sudo-apt-install-tap/Sonder/BOM.csv

Item | Qty | Supplier | Cost/item | Total Cost | link
PCB | 1 | JLCPCB | $1.50 | $1.50 | https://jlcpcb.com/
PCM5102 I2S Digital Audio DAC Decoder Module | 1 | hubtronics | $5.00 | $5.00 | https://hubtronics.in/pcm5102-i2s-digital-audio-dac-decoder-module
Robocraze ESP32 38 Pin | 1 | AMAZON | $6.50 | $6.50 | https://www.amazon.in/Robocraze-Development-Dual-Core-Performance-Bluetooth/dp/B078MNG9D5
SD Card Reader Module | 1 | ROBU | $1.00 | $1.00 | https://robu.in/product/micro-sd-card-module/
0.96 Inch I2C/IIC 4pin | 1 | ROBU | $2.00 | $2.00 | https://robu.in/product/4pin-oled-display-module-blue-color/
Rotary Encoder with Switch | 1 | ROBU | $1.00 | $1.00 | https://robu.in/product/hongyan-ec11h-7ce20p1zd20-rotary-encoder-with-push-button-switch-vertical-plug-in-5-pin/
Tactile push buttons 6x6x8 | 1 | ROBU | $0.50 | $0.50 | https://robu.in/product/6x6x8mm-tactile-push-button-switch-pack-of-20/
HIKVISION Extreme 16GB microSDXC Memory Card | 1 | Amazon | $6.50 | $6.50 | https://www.amazon.in/HIKVISION-microSDXC-Compitable-Smartphones-Protection/dp/B0GVJZ56K5
CASE 3d print | 1 | Print Legion | $3.00 | $3.00 | https://hackclub.slack.com/archives/C083P4FJM46/p1793539514844309
Estimated total shipping | 1 |  |  | $3.00
