sudo-apt-install-tap/Sonder/CAD/pcb-Edge_Cuts.dxf

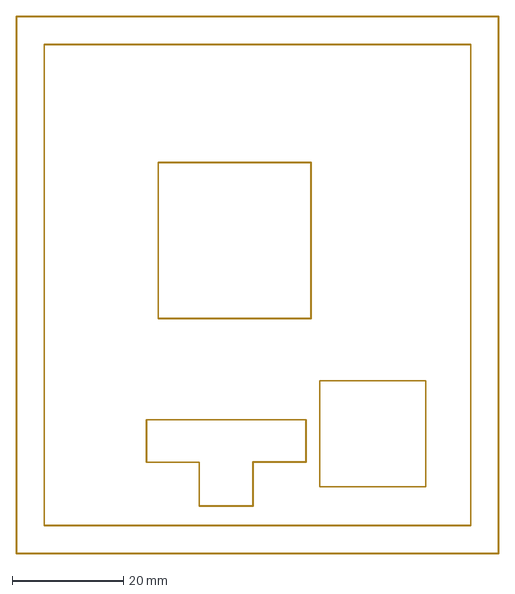
[picture p1: CAD file, 2026-11-01]
CAD/pcb-Edge_Cuts.dxf
86.6 x 96.5 mm
