sudo-apt-install-tap/Sonder/CAD/Case.step

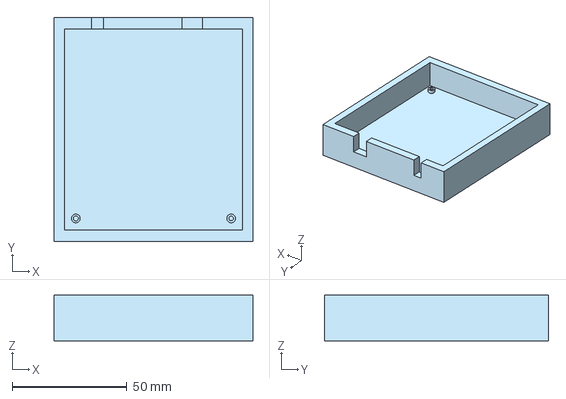
[picture p2: CAD file, 2026-11-01]
CAD/Case.step
86.6 x 97.4 x 20.0 mm
