sudo-apt-install-tap/Sonder/CAD/Plate.step

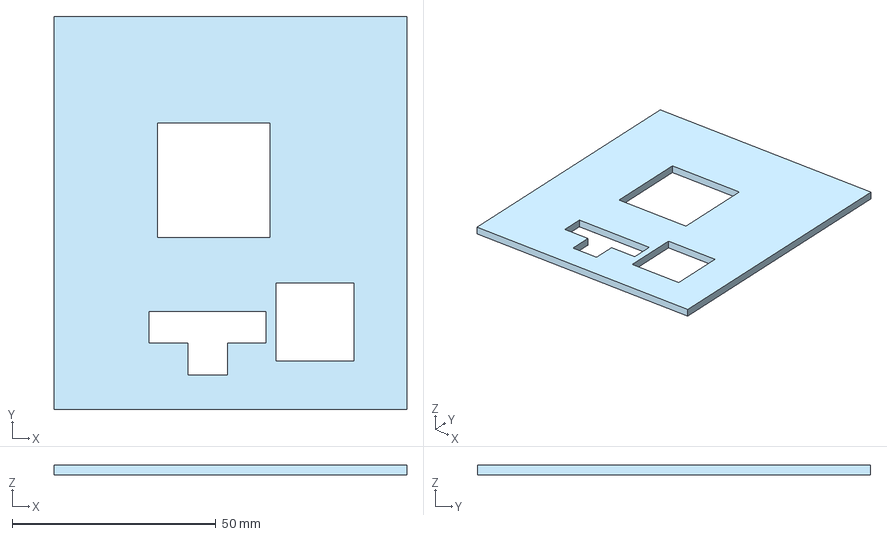
[picture p3: CAD file, 2026-11-01]
CAD/Plate.step
86.5 x 96.4 x 2.50 mm
