sudo-apt-install-tap/Sonder/CAD/pcb.step

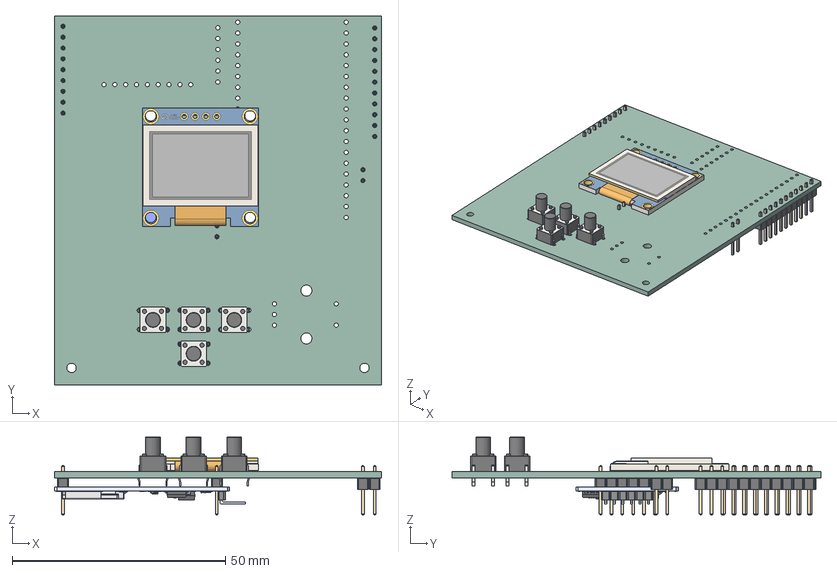
[picture p4: CAD file, 2026-11-01]
CAD/pcb.step
76.6 x 86.4 x 18.2 mm
SW_PUSH_6mm_h8mm x 4
OLED-TH_L27.8-W27.2-P2.54_C9900033791
PinHeader_1x06_P254mm_Vertical
Valor predeterminado
PinHeader_1x11_P254mm_Vertical
PinHeader_1x09_P254mm_Vertical
PinHeader_1x02_P254mm_Vertical
pcb-unsaved-export-SAPEkO_PCB
