sudo-apt-install-tap/Sonder/pcb/pcb.pdf

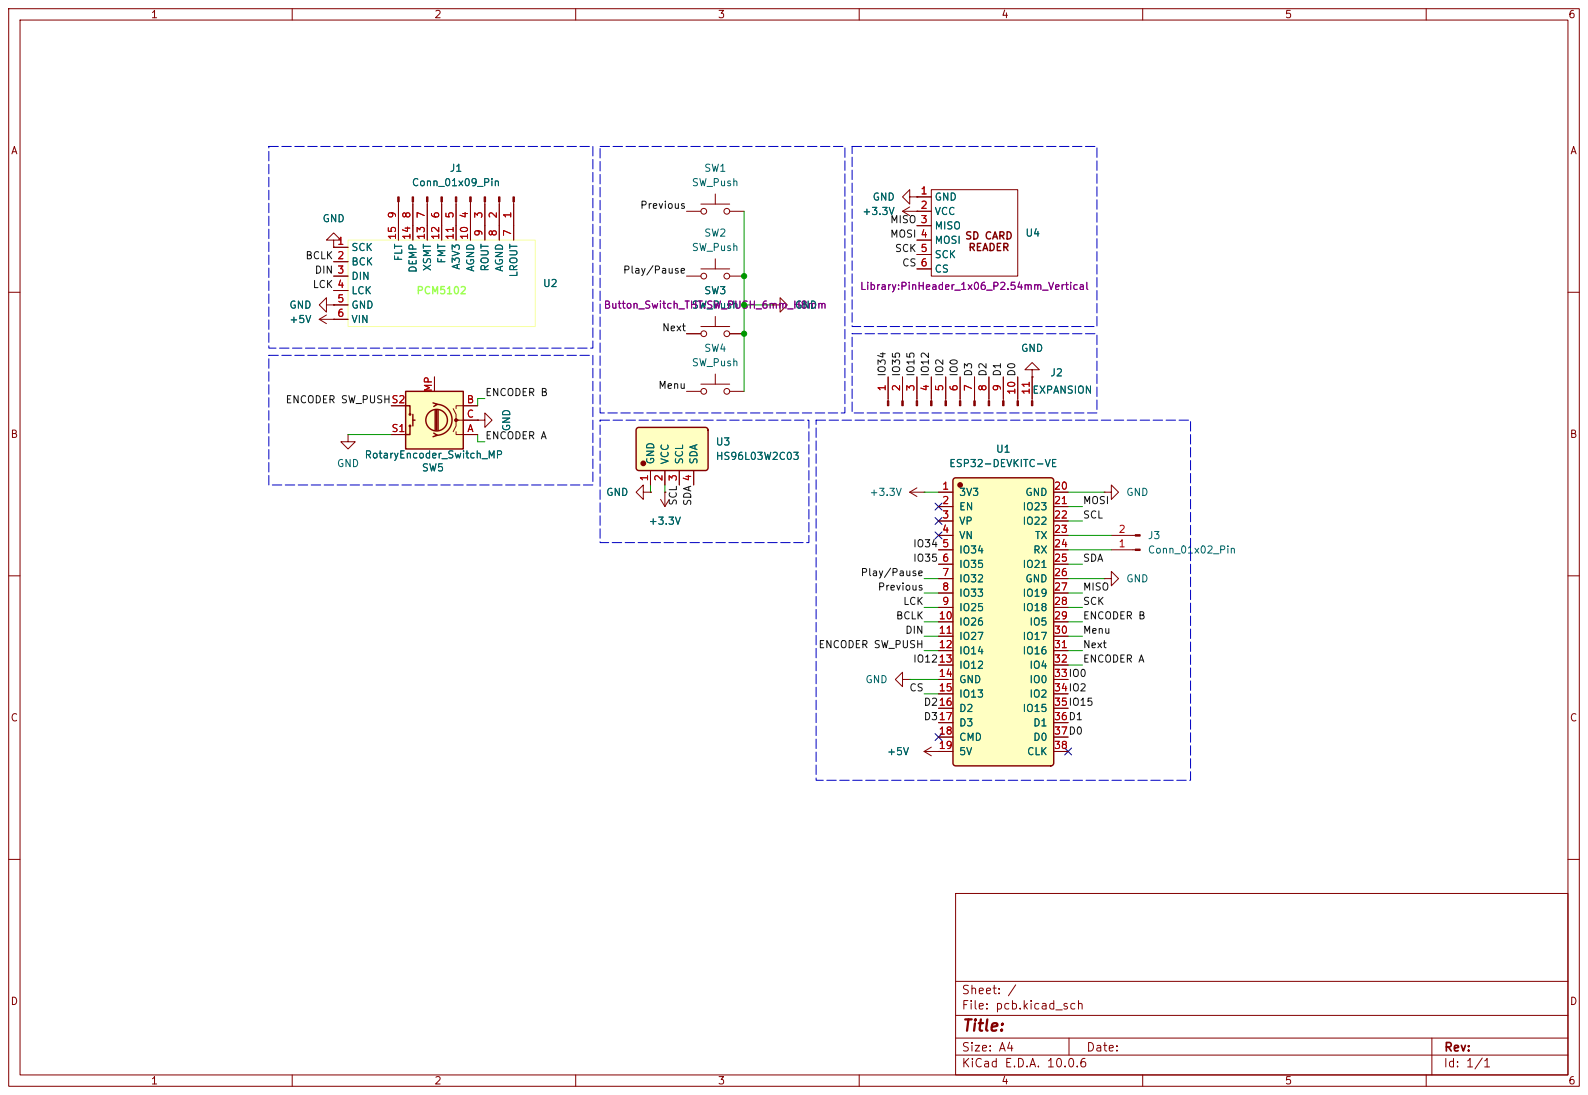
[picture p5: page 1]

8 ROUT 9 AGND 10 A3V3 11 FMT 12 XSMT 13 DEMP 14 FLT 15 U2 GND

8 ROUT 9 AGND 10 A3V3 11 FMT 12 XSMT 13 DEMP 14 FLT 15 GND U1

Play/Pause Next Menu ENCODER B

Size: A4 | Rev:
KiCad E.D.A. 10.0.6 | Id: 1/1
