sudo-apt-install-tap/Sonder/pcb/pcb.kicad_pcb

## KiCad design pcb/pcb.kicad_pcb (2026-11-01)

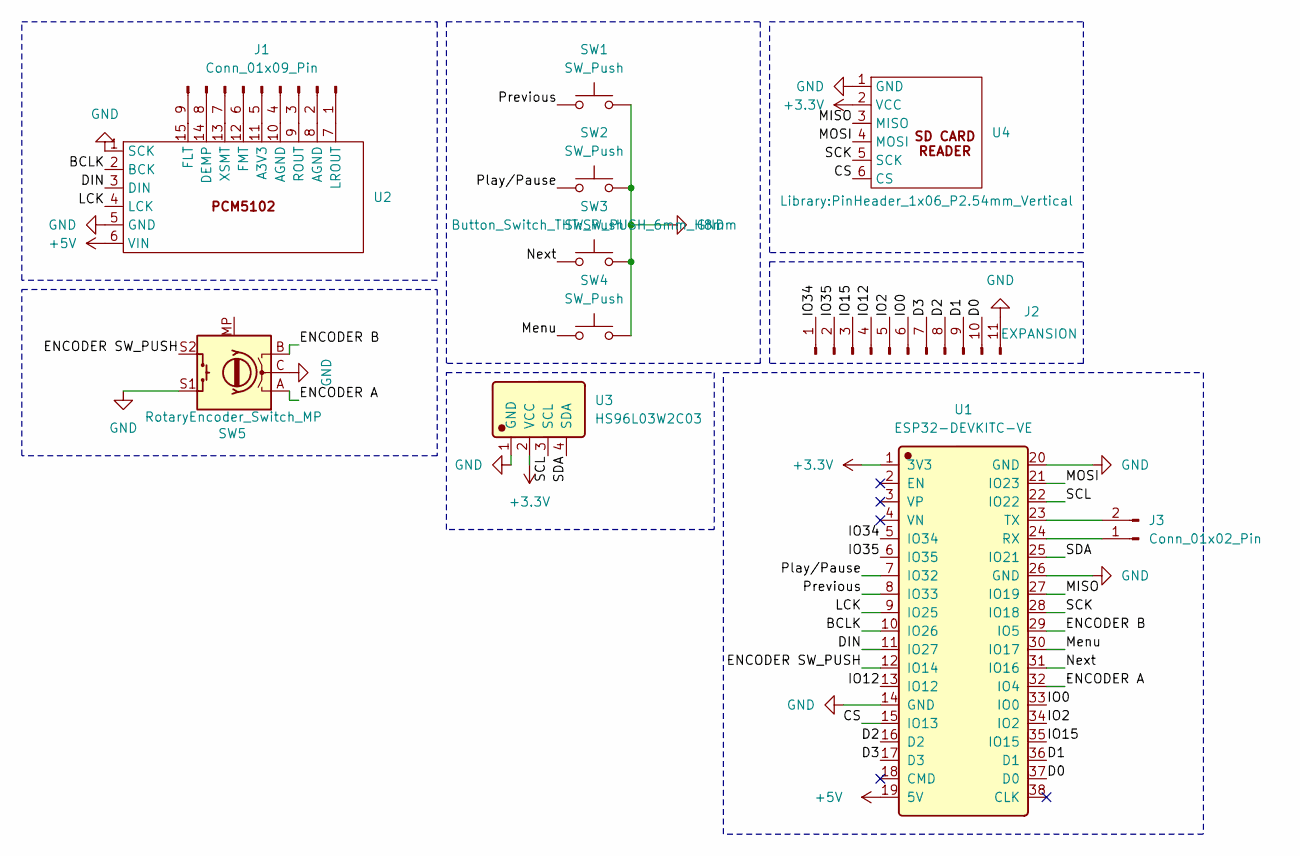
[picture p6: schematic pcb.kicad_sch]

Parts:
J1: Conn_01x09_Pin; PinHeader_1x09_P2.54mm_Vertical
J2: EXPANSION; PinHeader_1x11_P2.54mm_Vertical
J3: Conn_01x02_Pin; PinHeader_1x02_P2.54mm_Vertical
SW1, SW2, SW3, SW4: SW_Push; SW_PUSH_6mm_H8mm
SW5: RotaryEncoder_Switch_MP; RotaryEncoder_Alps_EC11E-Switch_Vertical_H20mm_CircularMoun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
U1: ESP32-DEVKITC-VE; Manufacturer Part ESP32-DEVKITC-VE; LCSC C20437001
U2: GY-PCM5102
U3: HS96L03W2C03; Manufacturer Part HS96L03W2C03; LCSC C5248080
U4: PinHeader_1x06_P2.54mm_Vertical

Connections:
+3.3V: U1.1 (3V3), U3.2 (VCC), U4.2 (VCC)
+5V: U1.19 (5V), U2.6 (VIN)
/BCLK: U1.10 (IO26), U2.2 (BCK)
/CS: U1.15 (IO13), U4.6 (CS)
/D0: J2.10, U1.37 (D0)
/D1: J2.9, U1.36 (D1)
/D2: J2.8, U1.16 (D2)
/D3: J2.7, U1.17 (D3)
/DIN: U1.11 (IO27), U2.3 (DIN)
/ENCODER A: SW5.A, U1.32 (IO4)
/ENCODER B: SW5.B, U1.29 (IO5)
/ENCODER SW_PUSH: SW5.S2, U1.12 (IO14)
/IO0: J2.6, U1.33 (IO0)
/IO2: J2.5, U1.34 (IO2)
/IO12: J2.4, U1.13 (IO12)
/IO15: J2.3, U1.35 (IO15)
/IO34: J2.1, U1.5 (IO34)
/IO35: J2.2, U1.6 (IO35)
/LCK: U1.9 (IO25), U2.4 (LCK)
/MISO: U1.27 (IO19), U4.3 (MISO)
/MOSI: U1.21 (IO23), U4.4 (MOSI)
/Menu: SW4.1, U1.30 (IO17)
/Next: SW3.1, U1.31 (IO16)
/Play/Pause: SW2.1, U1.7 (IO32)
/Previous: SW1.1, U1.8 (IO33)
/SCK: U1.28 (IO18), U4.5 (SCK)
/SCL: U1.22 (IO22), U3.3 (SCL)
/SDA: U1.25 (IO21), U3.4 (SDA)
GND: J2.11, SW1.2, SW2.2, SW3.2, SW4.2, SW5.C, SW5.S1, U1.14 (GND), U1.20 (GND), U1.26 (GND), U2.1 (SCK), U2.5 (GND), U3.1 (GND), U4.1 (GND)
unnamed: J1.1, U2.7 (LROUT)
unnamed: J1.2, U2.8 (AGND)
unnamed: J1.3, U2.9 (ROUT)
unnamed: J1.4, U2.10 (AGND)
unnamed: J1.5, U2.11 (A3V3)
unnamed: J1.6, U2.12 (FMT)
unnamed: J1.7, U2.13 (XSMT)
unnamed: J1.8, U2.14 (DEMP)
unnamed: J1.9, U2.15 (FLT)
unnamed: J3.1, U1.24 (RX)
unnamed: J3.2, U1.23 (TX)

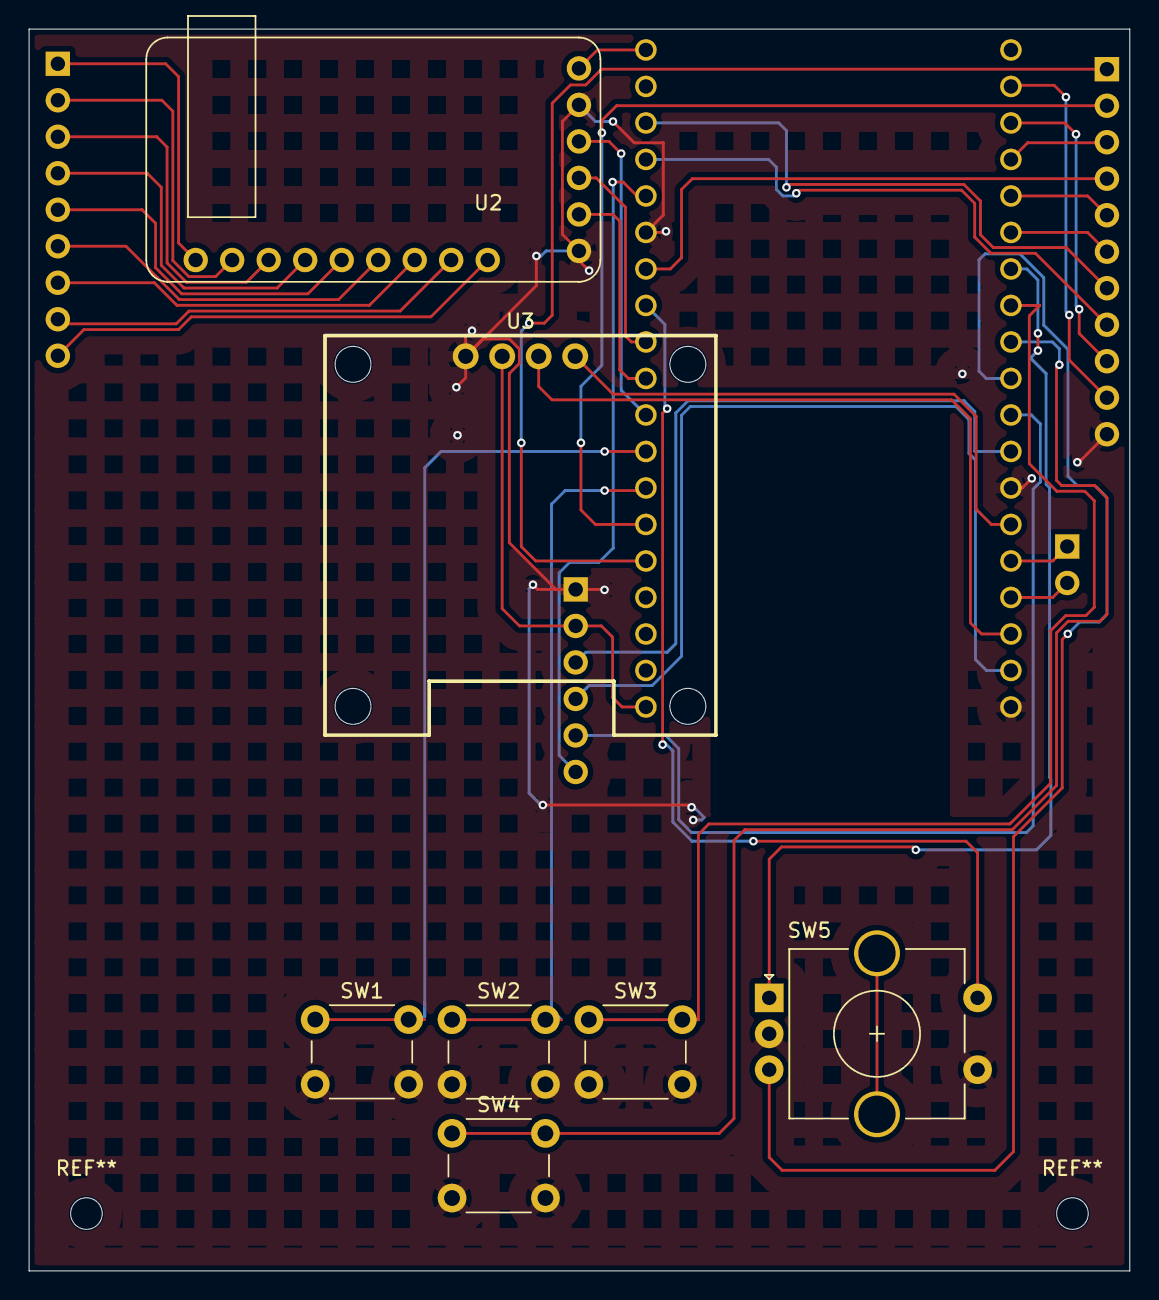
[picture p7: board pcb.kicad_pcb from above]

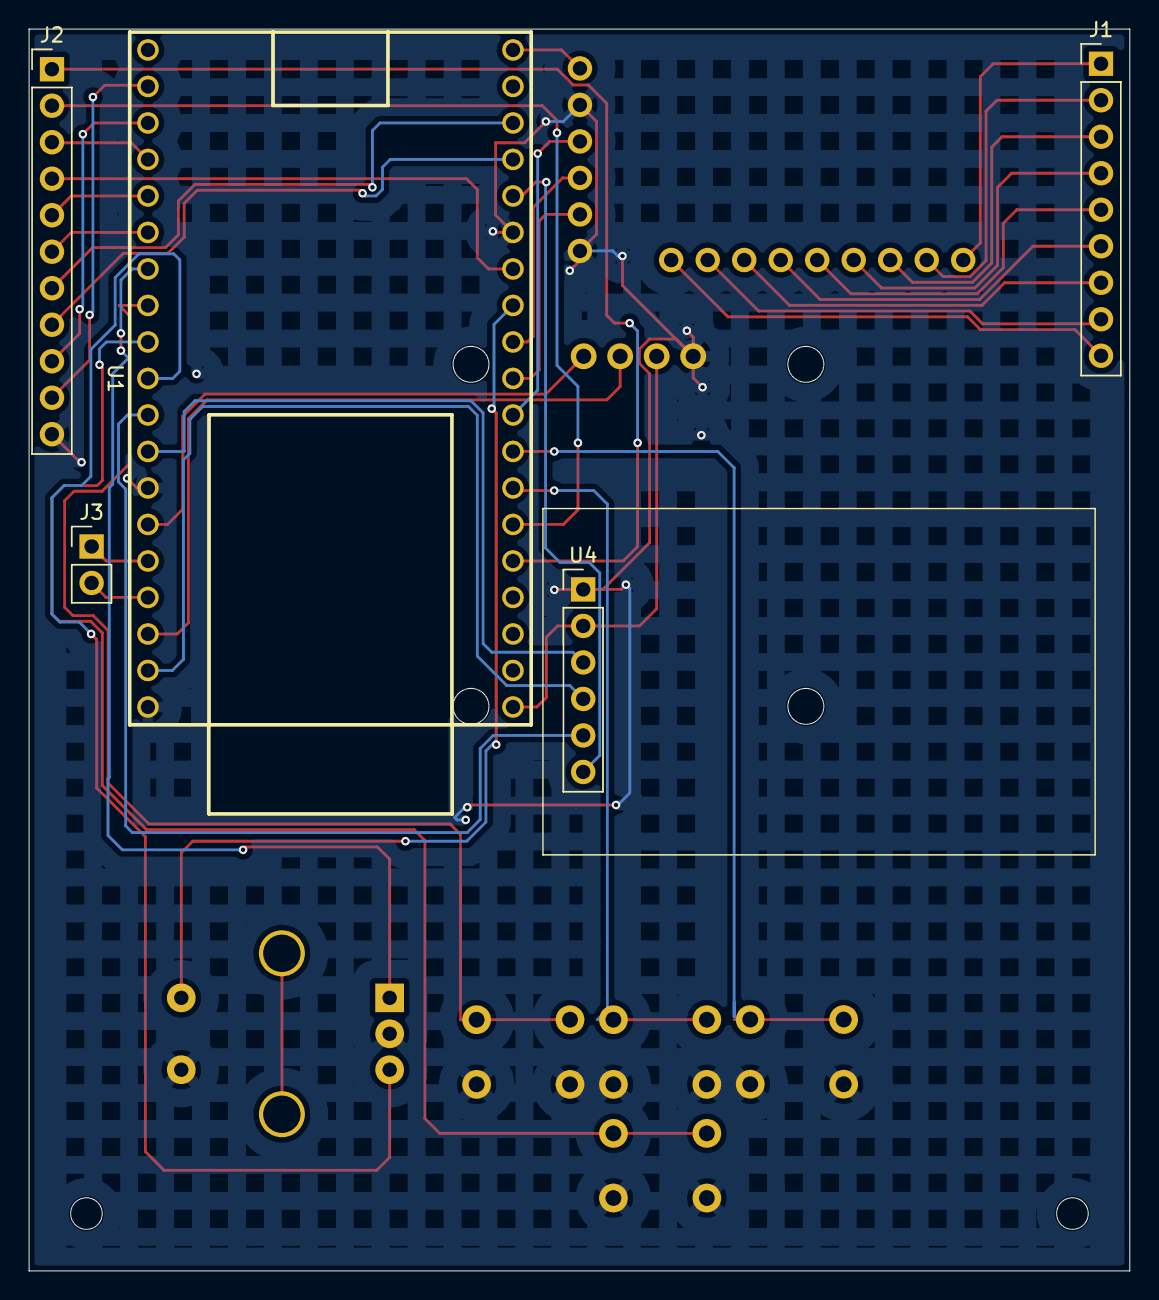
[picture p8: board pcb.kicad_pcb from below]

Board: 2 copper layers, 76.6 x 86.4 mm, 12 parts (5 on the bottom side), 40 nets.
