sudo-apt-install-tap/Sonder/JOURNAL.md

# MP3 Player: devlog

<!-- Generated by Half Life from project mgaa18s3veiecbwc88t2wuln. Edits here are overwritten on the next sync. -->
<!-- Generated: 2026-11-01T17:33:40.013Z -->

> [!NOTE]
> This devlog is mirrored from [Half Life](https://halflife.hackclub.com) ([open the project](https://halflife.hackclub.com/projects/mgaa18s3veiecbwc88t2wuln)). Editing it here will not change the platform's copy, and the next sync overwrites this file.

> A custom ESP32-based MP3 player featuring microSD storage, a PCM5102A DAC, an OLED display, physical buttons, and a rotary encoder. It will play locally stored music through a 3.5 mm audio jack, with a headphone amplifier added if needed. Designed for offline playback, modularity, and future upgrades.

| Week | Tier | Hours logged | Entries |
| --- | --- | --- | --- |
| Week 4 | Tier 1 | 14.5h | 5 |

## Contents

1. [2026-10-29: #  MP3 Player Devlog](#2026-10-29-mp3-player-devlog)
2. [2026-10-30: # MP3 Player Devlog 2](#2026-10-30-mp3-player-devlog-2)
3. [2026-11-01: # Changed the PCB a bit, and found listings and links for all parts.](#2026-11-01-changed-the-pcb-a-bit-and-found-listings-and-link)
4. [2026-11-01: # ITS CADIN TIME!](#2026-11-01-its-cadin-time)
5. [2026-11-01: # GITHUB ISN'T A FOE](#2026-11-01-github-isnt-a-foe)

## Design

### 2026-10-29: #  MP3 Player Devlog

**5.5h**

#  MP3 Player Devlog
## This Journal contains work from the last 2 days.

Started working on the schematic for my ESP32 MP3 player today. Somehow this went from “wouldn't it be funny if I built my own music player” to spending my time fighting KiCad. Anyway, here's the progress.

**1. The components**

ESP32, PCM5102 DAC, SD card reader, OLED, buttons, rotary encoder. The usual suspects.

Untitled design

AND YES THIS WAS MADE IN CANVA, WAGE A WAR ON ME IF YOU WANT!

**2. Making symbols**

Some components didn't have the symbols I needed, so I made my own. Because apparently drawing little boxes and naming pins is my life now.





**3. Footprint shenanigans**

Downloaded the DAC footprint and modified it, including fixing the pin numbering to match my symbol. One wrong pin and the PCB becomes an expensive piece of modern art. The SD card on the other hand was easy to make, just a 6pin connector with 2.54mm pitch and some silkscreen borders.





**4. The controls**

Added the buttons and rotary encoder for playback and navigation. Slowly starting to look like an actual device.





**5. FINALLY DONE**

Connected everything and finished the schematic. PCB design is next. Then comes the fun part: discovering everything I did wrong.



pcb_page-0001

FUCK SPOTIFY, WE BALL!

### 2026-10-30: # MP3 Player Devlog 2

**4h**

# MP3 Player Devlog 2
## PCB layout and routing, about 4 hours of work.

The schematic was the easy part. Turns out drawing wires between boxes is a lot less stressful than figuring out where the boxes physically go. This session was all about turning the schematic into an actual board.

**1. Choosing the layout**

My main question was whether this should be a one-sided board with everything crammed on top or a two-sided sandwich. I went with the sandwich:

- **Top side:** the stuff you touch and look at, which is the OLED, the buttons and the rotary encoder.
- **Bottom side:** the stuff you don't need to see, which is the ESP32, the SD card module and the PCM5102 DAC.

This keeps the board small enough to hold like an actual music player instead of a circuit board with a screen on it.



**2. Placing the big parts first**

The ESP32 went down first since everything else connects to it. I put it so the antenna end sits at the edge of the board, because copper and ground pour near the antenna ruin the Wi-Fi/Bluetooth range. The SD card module went on the right with its slot facing the board edge so the card can actually be removed. The DAC went near the top, away from the SD card's noisy SPI lines.





**3. The controls**

Four buttons in a T shape (previous, play/pause, next, and a menu button under the middle one), with the rotary encoder at the bottom right where a thumb would naturally land. The OLED sits above all of that. I'm not claiming it's perfectly ergonomic, but it should feel like a real device.



**4. SD card shenanigans**

My first SD module placement had its angled header tails running straight into the ESP32. I decided I wasn't going to use the angled header anyway, and the module in the layout is basically a placeholder for the real connection, so I'm treating it as a mockup for now.



**5. Routing**

This is where the 4 hours really went. The main things I was trying to do:

- Keep the I2S lines (BCK, LRCK, DIN) short and away from the SD card's SPI lines, since mixing a fast clock with audio is a good way to hear it later.
- Keep the OLED I2C and button lines tidy, because they don't care much as long as they connect.
- Pour ground on both layers and stitch it together with vias, so signals have a clean return path and there are no isolated copper islands.
- Keep copper out from under the ESP32 antenna.











**6. Next**

CAD and Firmware, for CAD I can figure something out but for the firmware I have to read some more docs.

### 2026-11-01: # Changed the PCB a bit, and found listings and links for all parts.

**2.25h**

# Changed the PCB a bit, and found listings and links for all parts.

So, this is something I needed to do after realizing the button footprint I chose before is not something that is very abundant in most electronic retailer's armory. Even in the rare few listings available in my country cost a LOT i am talking like 0.5USD with a MOQ of 20. So I switched to a standard 6x6x8 mm button footprint which is much more available.



Also I realized that I would be needing some mounting holes for the case. Which led me to use m2 mounting holes on the two corners of the board at a distance of 4mm of either end.



Finally about the listings, it was genuinely VERY HARD to find the listings for a esp32 which had the footprint I used in the project, eventually with the help of Gemini and Claude i found a suitable ESP32 board.



Anyway this is how the BOM looks now!


### 2026-11-01: # ITS CADIN TIME!

**2.25h**

# ITS CADIN TIME!

# MP3 Player Devlog 3
## This journal contains about 2.25 hours of work.

The PCB is routed, which means my music player is now a very fancy circuit board with no way to hold it. Time to give it a body. This session was all about designing the case in Onshape.

**1. The plan**

The case is two parts: a main body that holds the board, and a separate front plate that the screen and controls poke through. The whole thing is going to be 3D printed, because of course it is.



**2. The case body**

Here's the top view of the body. It's a rounded rectangle with an inner wall offset, leaving a hollow for the PCB. There are two notches along the top edge, which are the holes for the aux jack and the USB-B port. I also added two circular features at the bottom corners [what are these, e.g. standoffs or screw bosses?].

The PCB mounts inside using heat set inserts and M2 screws, so I'm not just hoping the board stays put.



**3. The front plate**

The plate has three cutouts:

- **OLED window:** a square opening for the display.
- **Button cutout:** a T-shaped opening that matches the T layout of the four buttons.
- **Encoder cutout:** a square opening at the bottom right for the rotary encoder.

I made it by drawing the cutouts on the Edge.Cuts layer in KiCad, directly over the real footprints, so the openings line up with the parts. Then I exported it as a DXF and brought it into Onshape.



**4. Putting it together**

In the 3D view, the display, the button cluster and the encoder all show through their cutouts. The T-shaped button opening came out nicely, and it's clear which button is which.



**5. Next**

I have to make the repo and write the repo!

### 2026-11-01: # GITHUB ISN'T A FOE

**0.5h**

# GITHUB ISN'T A FOE

Well it was just a lot of writting and some command to sync my files via git cli.

**1. The README**

Wrote the README for SONDER: an overview of the player, the CAD section (two part case, front plate cutouts drawn on Edge.Cuts in KiCad, heat set inserts and M2 screws), and spots for all the renders and PCB screenshots.



**2. The BOM**

Put the full BOM into the README: PCB, ESP32, PCM5102 DAC, SD module, OLED, encoder, buttons, microSD card and the printed case. It comes to $27.00 in parts plus $3.00 shipping, so $30.00 total.
