sudo-apt-install-tap/Sonder/(commit log)

2026-11-01 Create README for ESP32 MP3 Player project
    Added detailed project description, images, and links.
2026-11-01 Sync MP3 Player from Half Life
    [BOM.csv]
2026-11-01 Enhance README with BOM and images
    Updated the README to include a BOM section and additional images.
